BAHIR-M/R-cap-Scieway-Awake-Challenge-/Documents/ScieWay_Presentation_PJT.pdf

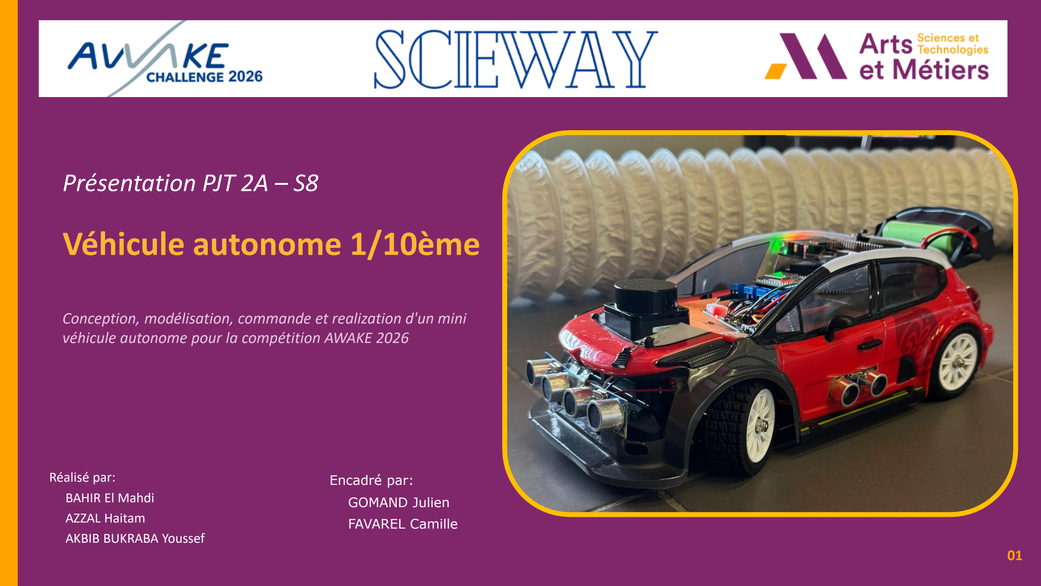
[picture p19: page 1]

# Véhicule autonome 1/10ème

## Conception, modélisation, commande et realization d'un mini véhicule autonome pour la compétition AWAKE 2026

01

## Réalisé par: BAHIR El Mahdi AZZAL Haitam AKBIB BUKRABA Youssef

### Encadré par:

### GOMAND Julien

### FAVAREL Camille

# Présentation PJT 2A – S8

S c i e W a y • A W A K E C h a l l e n g e 2 0 2 6

# Équipe ScieWay — Arts et Métiers

## 3 étudiants en 2ème année de même classe

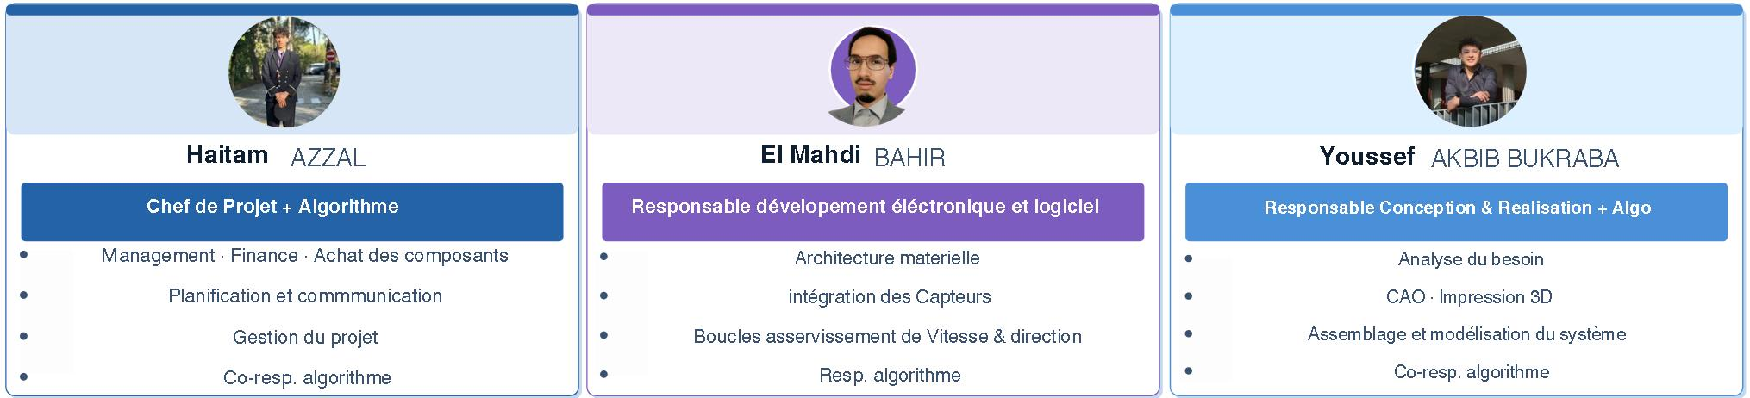
[picture p20: figure]

# L'AWAKE Challenge 2026

## 5ème édition du concours national de véhicules autonomes miniatures

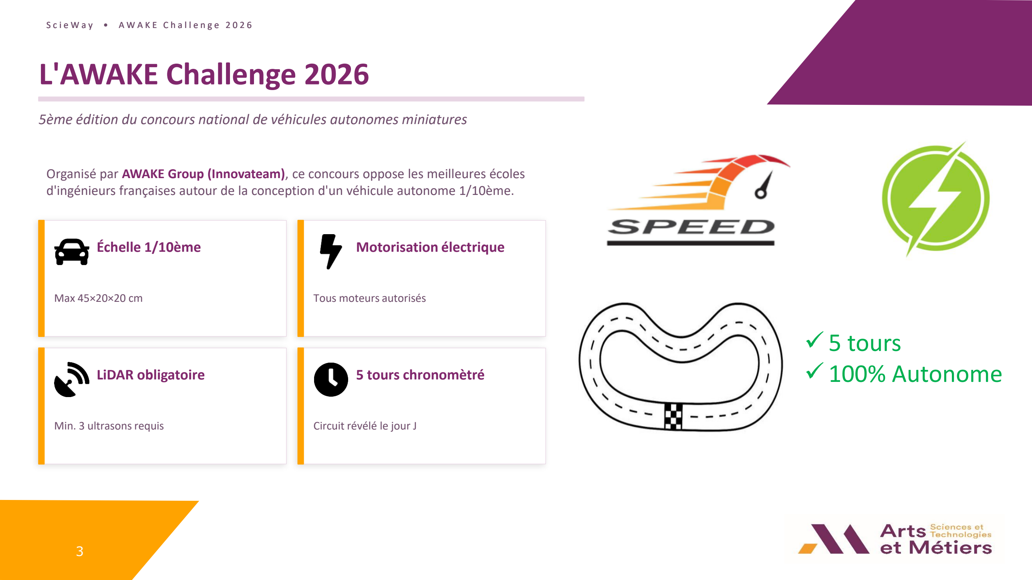
[picture p21: page 3]

## Organisé par AWAKE Group (Innovateam), ce concours oppose les meilleures écoles

d'ingénieurs françaises autour de la conception d'un véhicule autonome 1/10ème.

## Échelle 1/10ème

### Max 45×20×20 cm

## Motorisation électrique

### Tous moteurs autorisés

## LiDAR obligatoire

### Min. 3 ultrasons requis

## 5 tours chronomètré

### Circuit révélé le jour J

4 000 €

# ✓5 tours ✓100% Autonome

# Vue système — Architecture

## Deux niveaux de commande : haut niveau (RPi5) + bas niveau (ESP32)

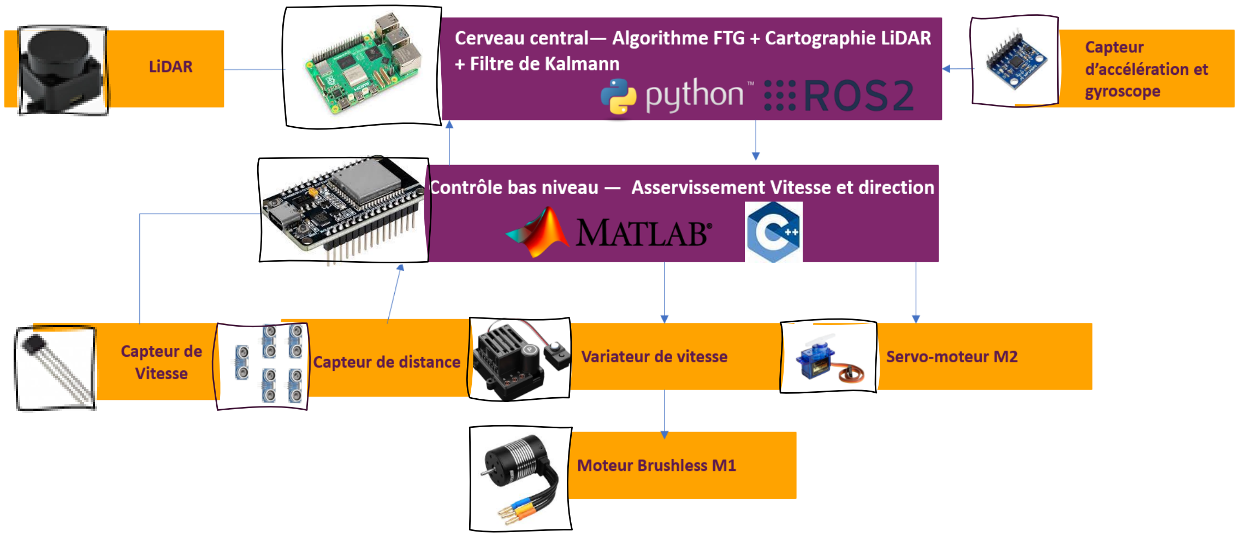
[picture p22: figure]

# Réalisation du prototype

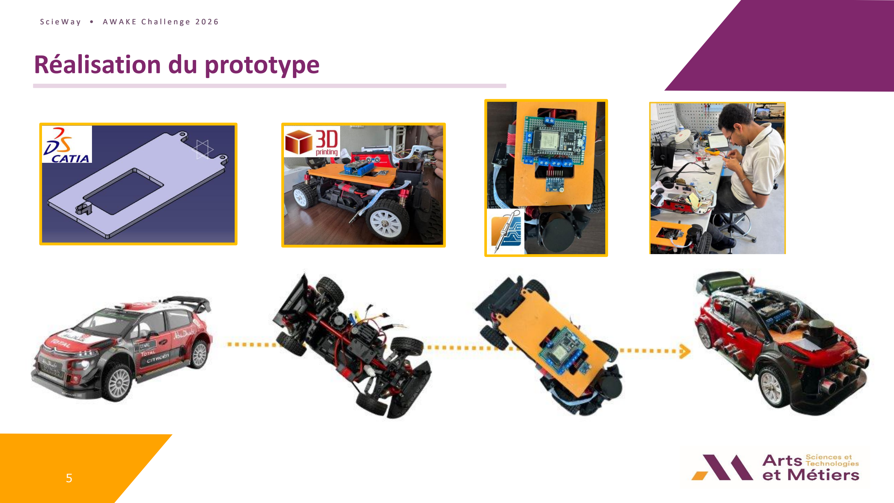
[picture p23: page 5]

# Algorithme Follow The Gap (FTG)

## Navigation réactive purement basée sur le scan LiDAR

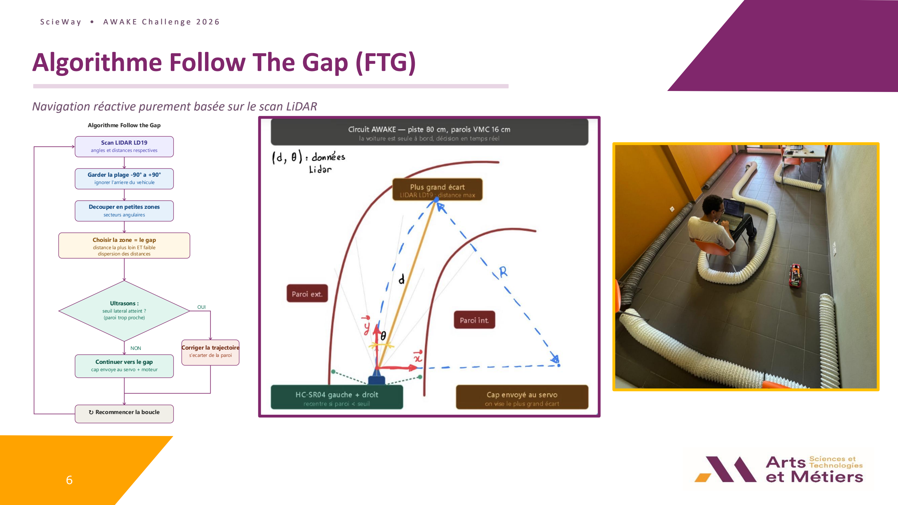
[picture p24: page 6]

# Modélisation cinématique du système

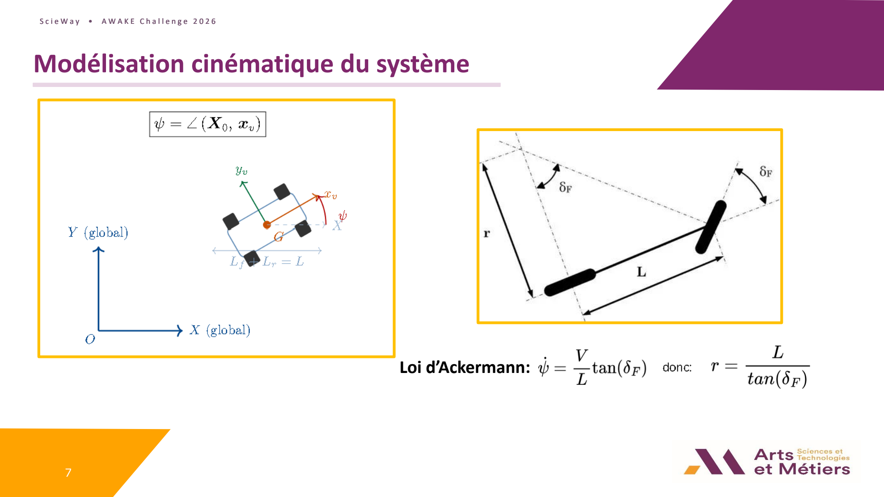
[picture p25: page 7]

# Loi d’Ackermann:

# Paramètres intrinsèques de la voiture

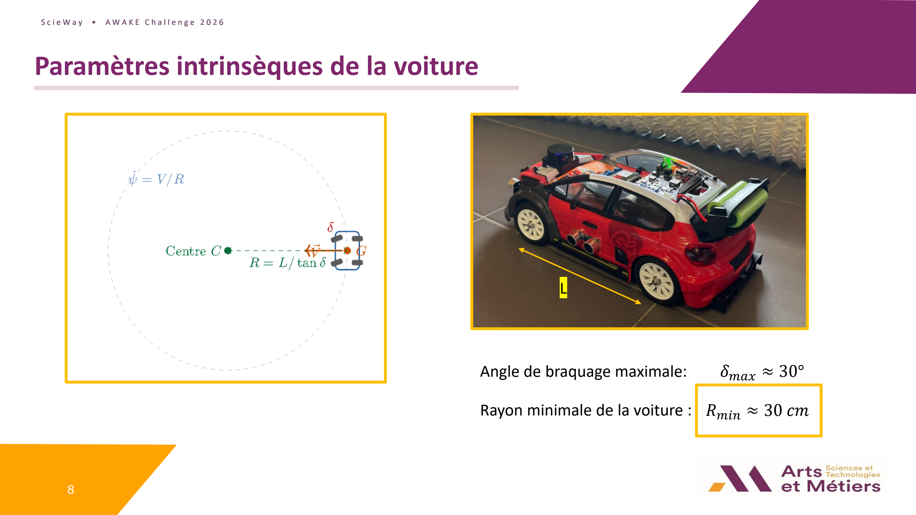
[picture p26: page 8]

Angle de braquage maximale: | δmax ≈ 30°
Rayon minimale de la voiture : | Rmin ≈ 30 cm

L

# D’après le couple (distance, angle) du Gap capté par le

# Angle de commande à chaque scan Ld19

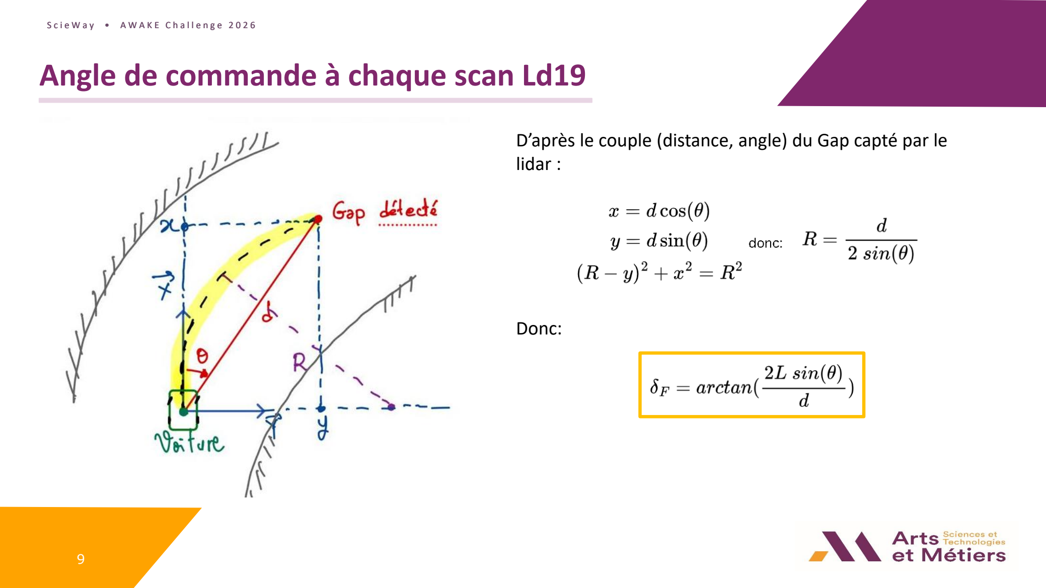
[picture p27: page 9]

# lidar :

# Donc:

## Caractérisation statique PWM → vitesse linéaire

# Identification expérimentale du système

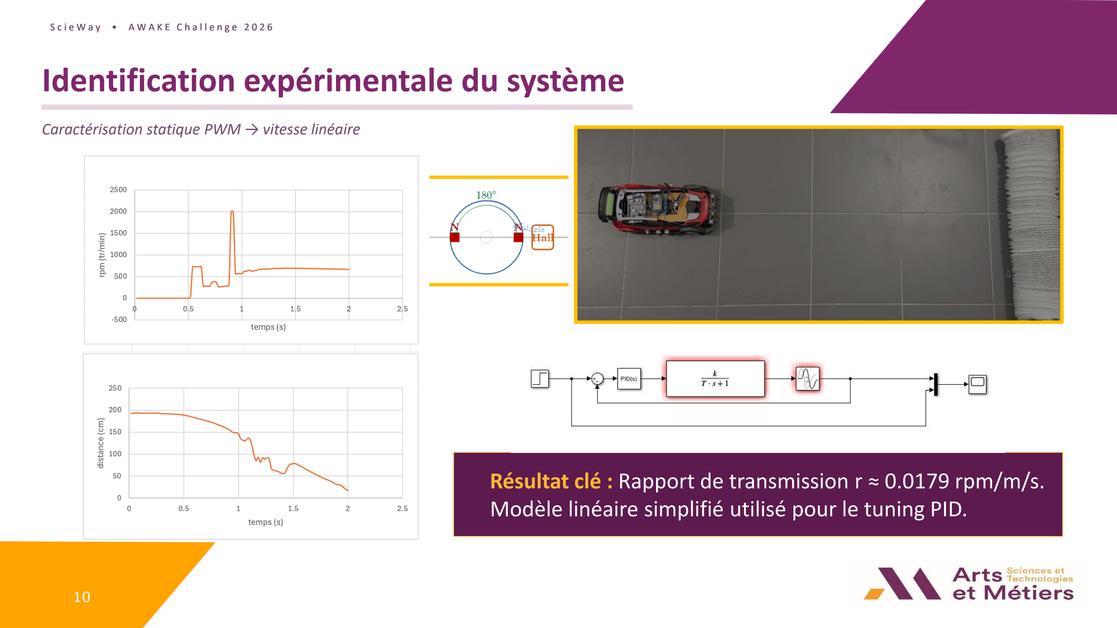
[picture p28: page 10]

Résultat clé : Rapport de transmission r ≈ 0.0179 rpm/m/s. Modèle linéaire simplifié utilisé pour le tuning PID.

# Filtre de Kalman — Fusion de capteurs

## Estimation optimale de l'état complet du véhicule

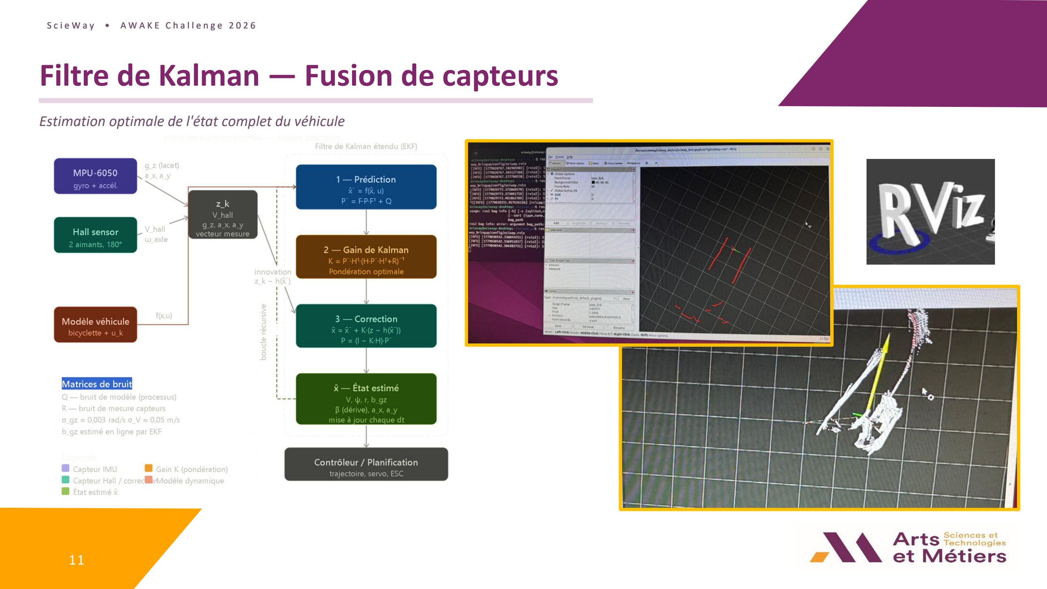
[picture p29: page 11]

# Performances finales — Indicateurs clés

## Circuit d'essai exemplaire — données reproductibles

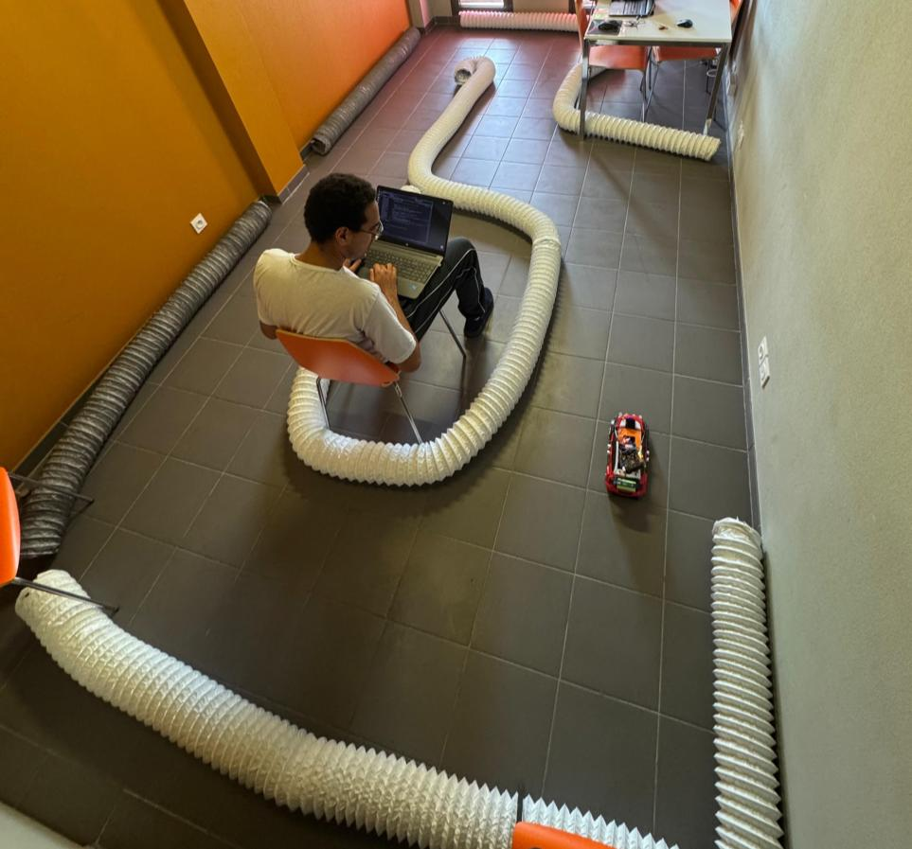
[picture p30: figure]

# ✓ Domaine de validité: 0 à 2 m/s ✓ 5 tours (Essai) ✓ Robuste

X | Perte de contrôle à V > 2 m/s
X | Pas de cartographie
X | Vitesse constante

# Performances finales — Indicateurs clés

## Circuit d'essai exemplaire — données reproductibles

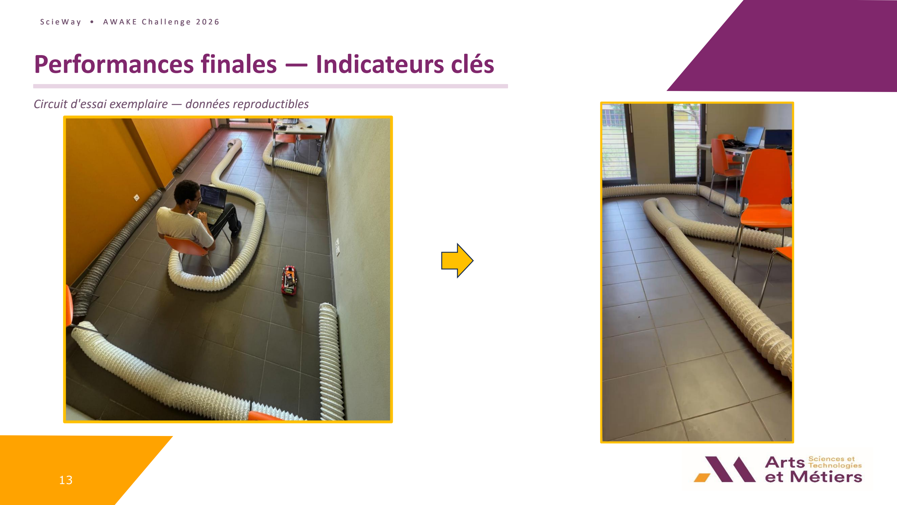
[picture p31: page 13]

# Perspectives d’amélioration

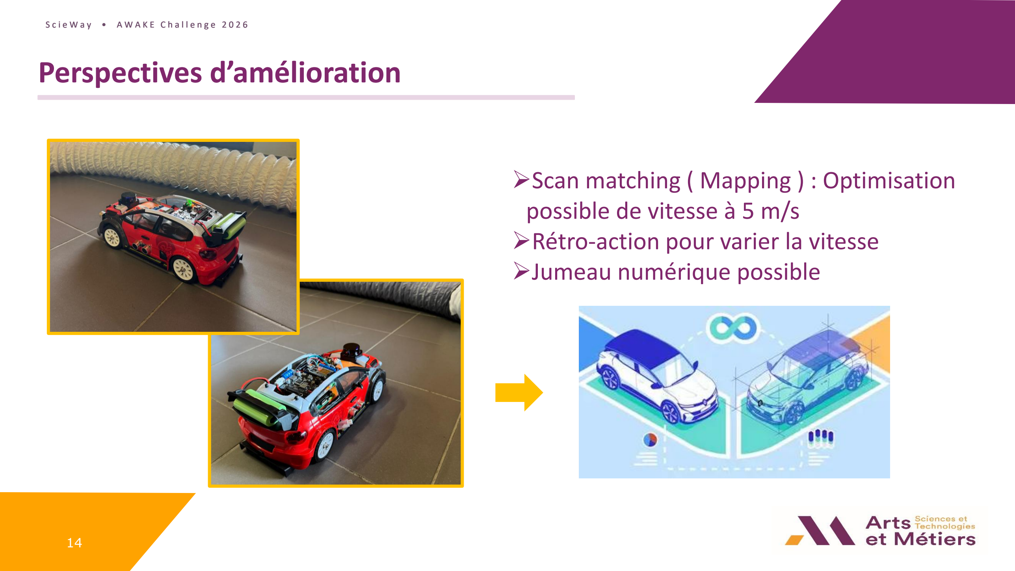
[picture p32: page 14]

# ➢Scan matching ( Mapping ) : Optimisation possible de vitesse à 5 m/s ➢Rétro-action pour varier la vitesse ➢Jumeau numérique possible

# Bilan budgétaire

## 750 € engagés sur 900 € — 83 % du budget utilisé

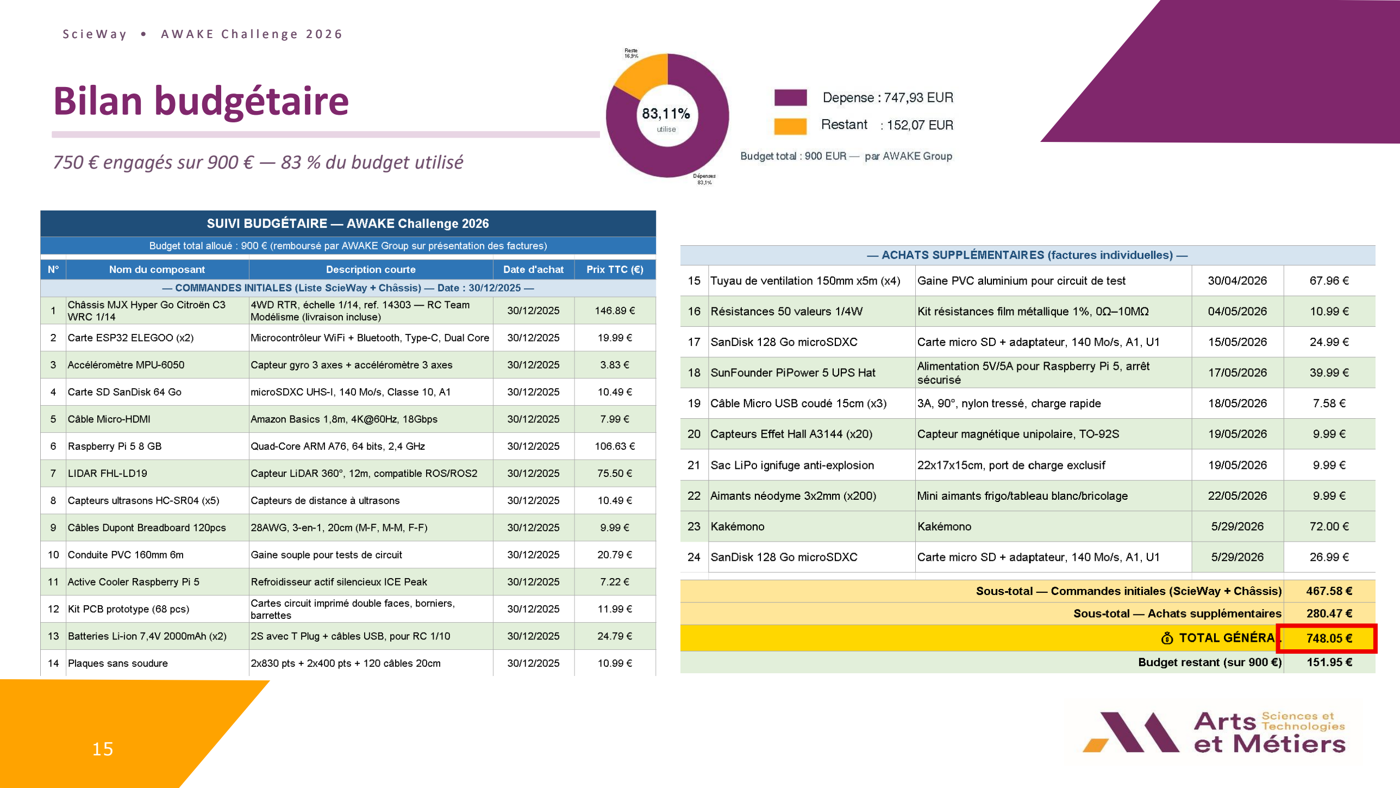
[picture p33: page 15]

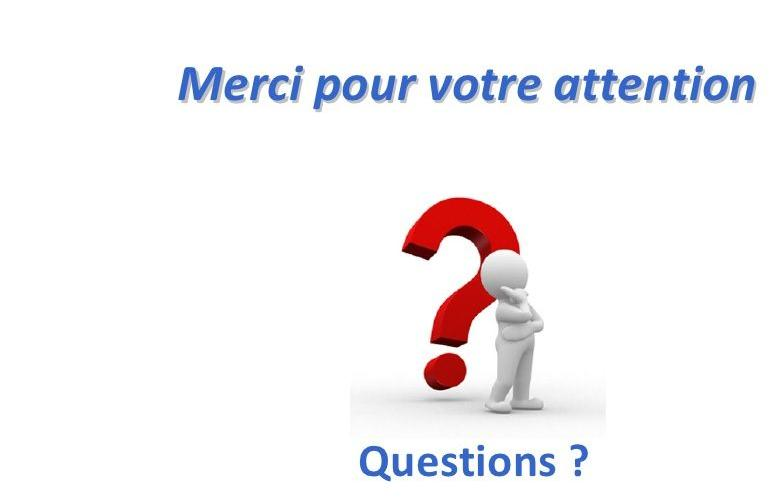
[picture p34: figure]
