BAHIR-M/R-cap-Scieway-Awake-Challenge-/Photos et Videos/1781671965392.jpg

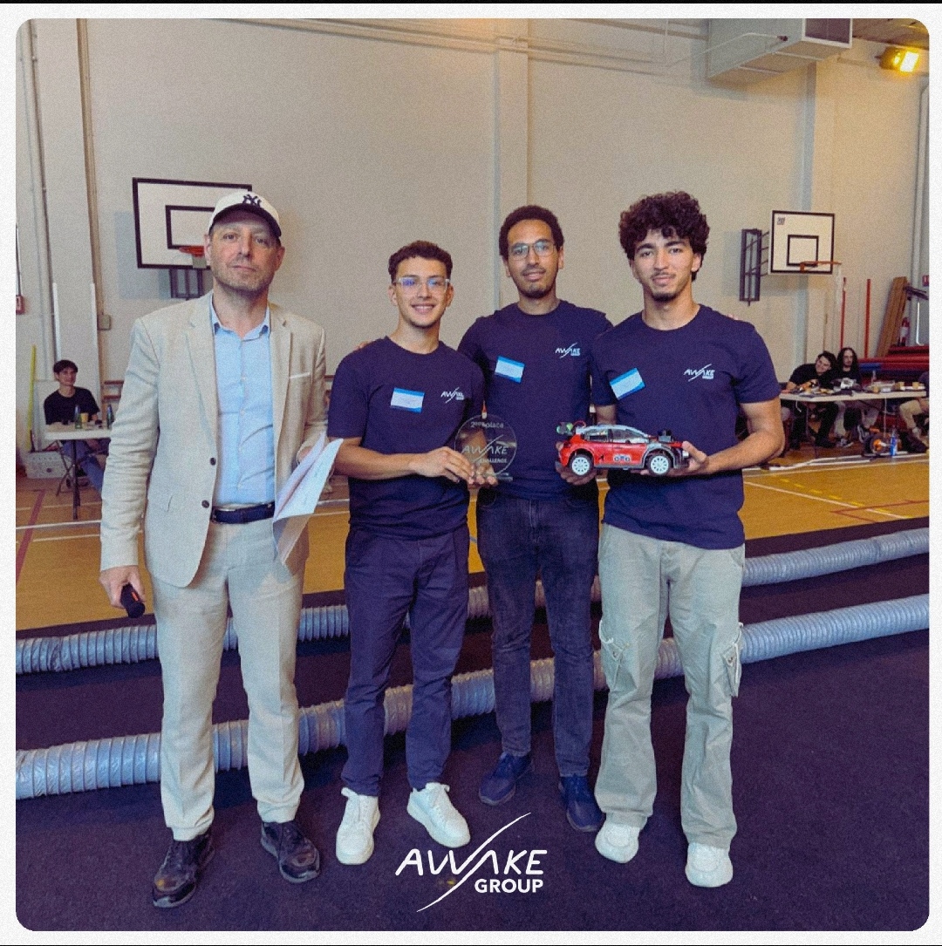
Photos et Videos/1781671965392.jpg
