BAHIR-M/R-cap-Scieway-Awake-Challenge-/Photos et Videos/1781671965752.jpg

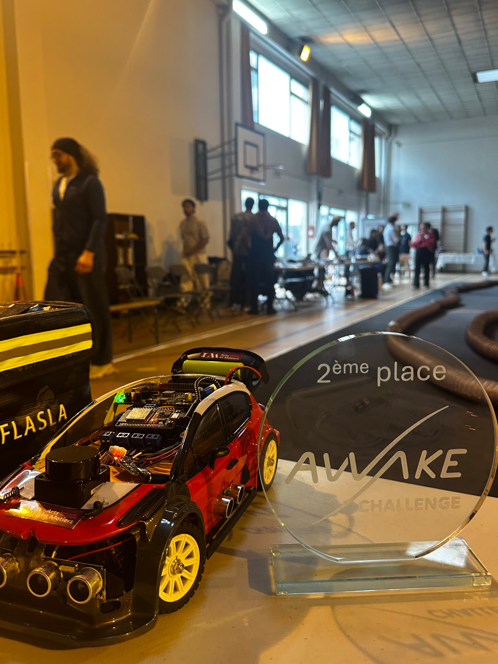
Photos et Videos/1781671965752.jpg
