BAHIR-M/R-cap-Scieway-Awake-Challenge-/Photos et Videos/IMG-20260529-WA0009.jpeg

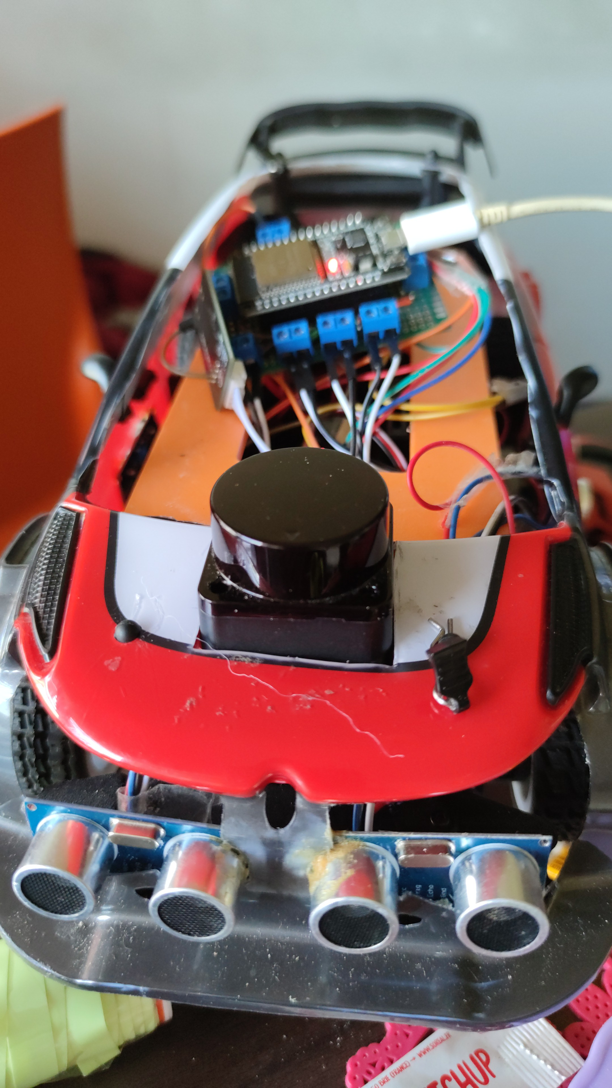
Photos et Videos/IMG-20260529-WA0009.jpeg
