BAHIR-M/R-cap-Scieway-Awake-Challenge-/Photos et Videos/IMG-20260529-WA0026.jpg

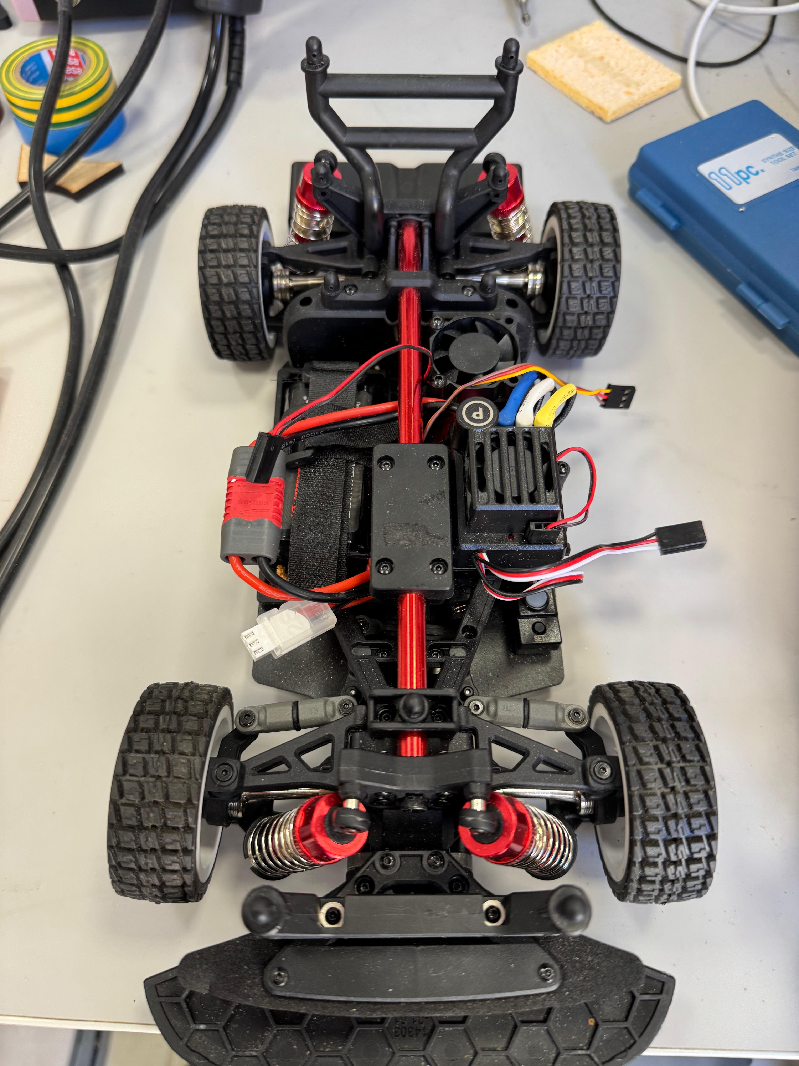
Photos et Videos/IMG-20260529-WA0026.jpg
