BAHIR-M/R-cap-Scieway-Awake-Challenge-/Photos et Videos/IMG-20260529-WA0028.jpg

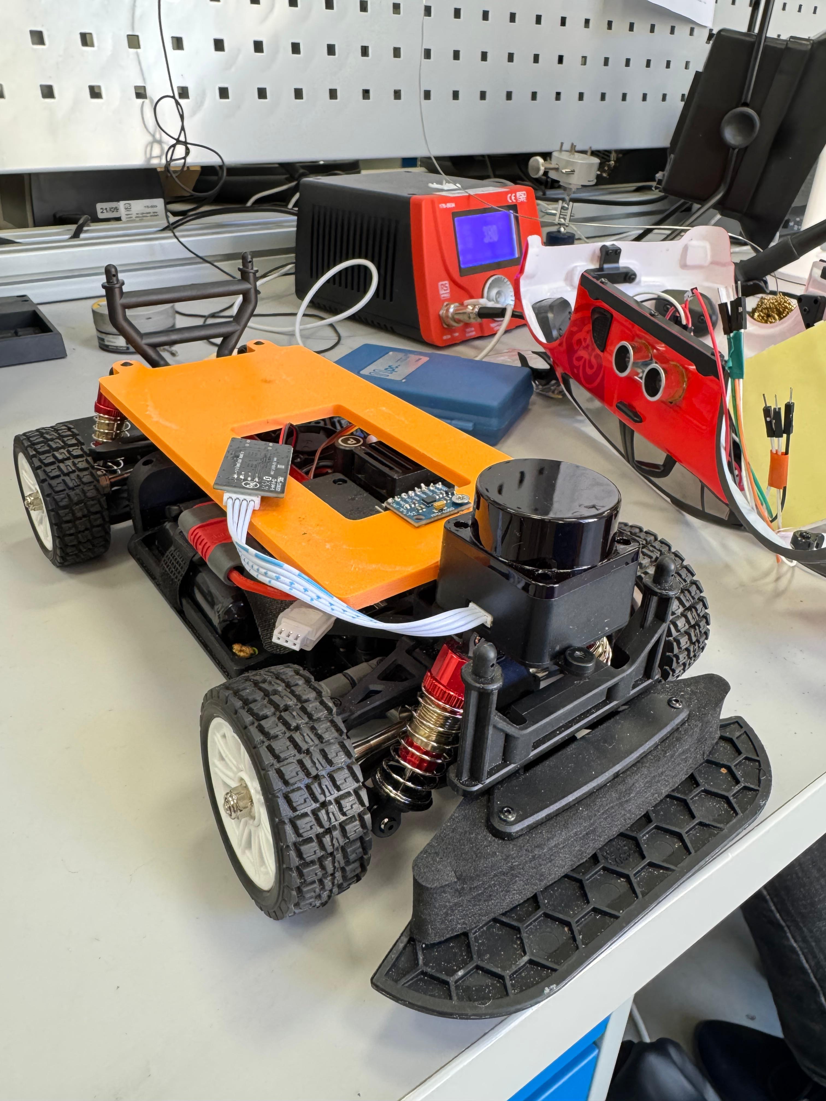
Photos et Videos/IMG-20260529-WA0028.jpg
