BAHIR-M/R-cap-Scieway-Awake-Challenge-/Photos et Videos/IMG-20260603-WA0131.jpg

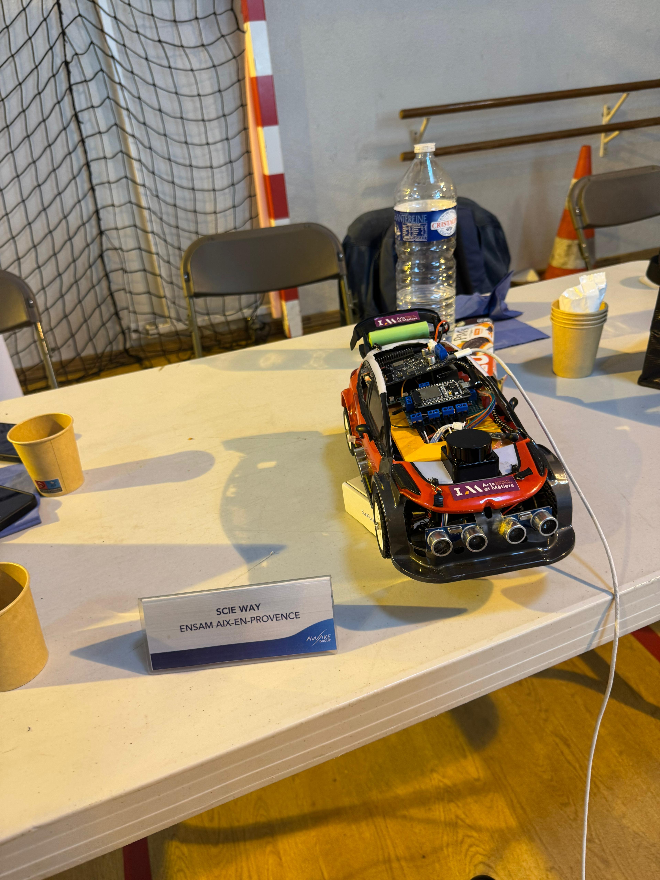
Photos et Videos/IMG-20260603-WA0131.jpg
