BAHIR-M/R-cap-Scieway-Awake-Challenge-/Documents/Poster_Voiture_Autonome.pdf

# MINI-VOITURE AUTONOME

## Contexte & Objectifs :

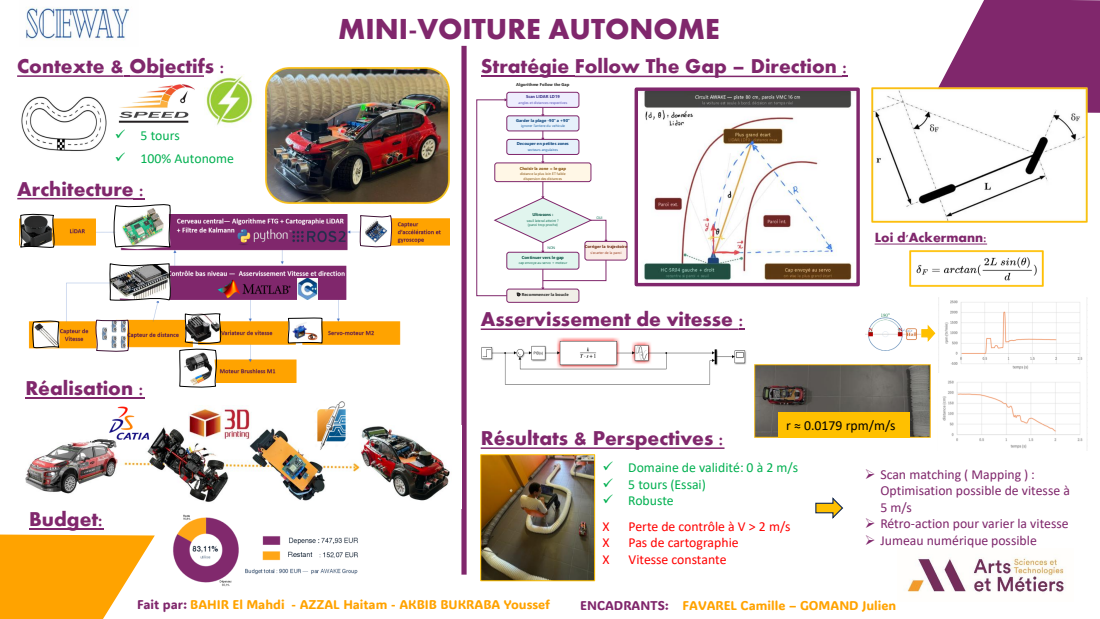
[picture p54: page 1]
Fait par: BAHIR El Mahdi - AZZAL Haitam - AKBIB BUKRABA Youssef; ENCADRANTS: FAVAREL Camille – GOMAND Julien; Réalisation :; Architecture :; 5 tours; 100% Autonome; Budget:; Loi d'Ackermann:; Résultats & Perspectives :; r ≈ 0.0179 rpm/m/s; Domaine de validité: 0 à 2 m/s; 5 tours (Essai); Robuste; Perte de contrôle à V > 2 m/s; Pas de cartographie; Vitesse constante

Stratégie Follow The Gap – Direction :

Asservissement de vitesse :

➢ Scan matching ( Mapping ) :
Optimisation possible de vitesse à
➢ Rétro-action pour varier la vitesse
➢ Jumeau numérique possible
