BAHIR-M/R-cap-Scieway-Awake-Challenge-/(commit log)

2026-06-17 Add LIDAR processing, ESP32 control and assets
    Add ESP_follow_gap.ino (ESP32 Arduino sketch) and lidar_ld19.py (LD19 LIDAR parser + gap detector). The ESP sketch reads serial gap commands, drives a steering servo and ESC with a PID speed loop, reads multiple ultrasonic sensors and a hall encoder; includes ESC arming and input rate limiting. The Python script implements LD19 packet parsing/CRC, accumulates scans to ensure angular coverage, finds the largest forward gap, scales the gap center, and sends "<angle>,<rpm>\n" to the ESP. Also add project documentation (reports, posters, cahier des charges, presentation, kakemono) and a collection of photos/videos for the ScieWay project.
2026-11-11 Revise installation instructions for LiDAR and ESP32
    Updated connection instructions for LiDAR and ESP32 in README.
